shafin244/Team-Boolean-Autocrates_SAP-1-Architecture-based-8-bit-Computer-Design/BOOLEAN AUTOCRATS_SAP 1_FINAL.png

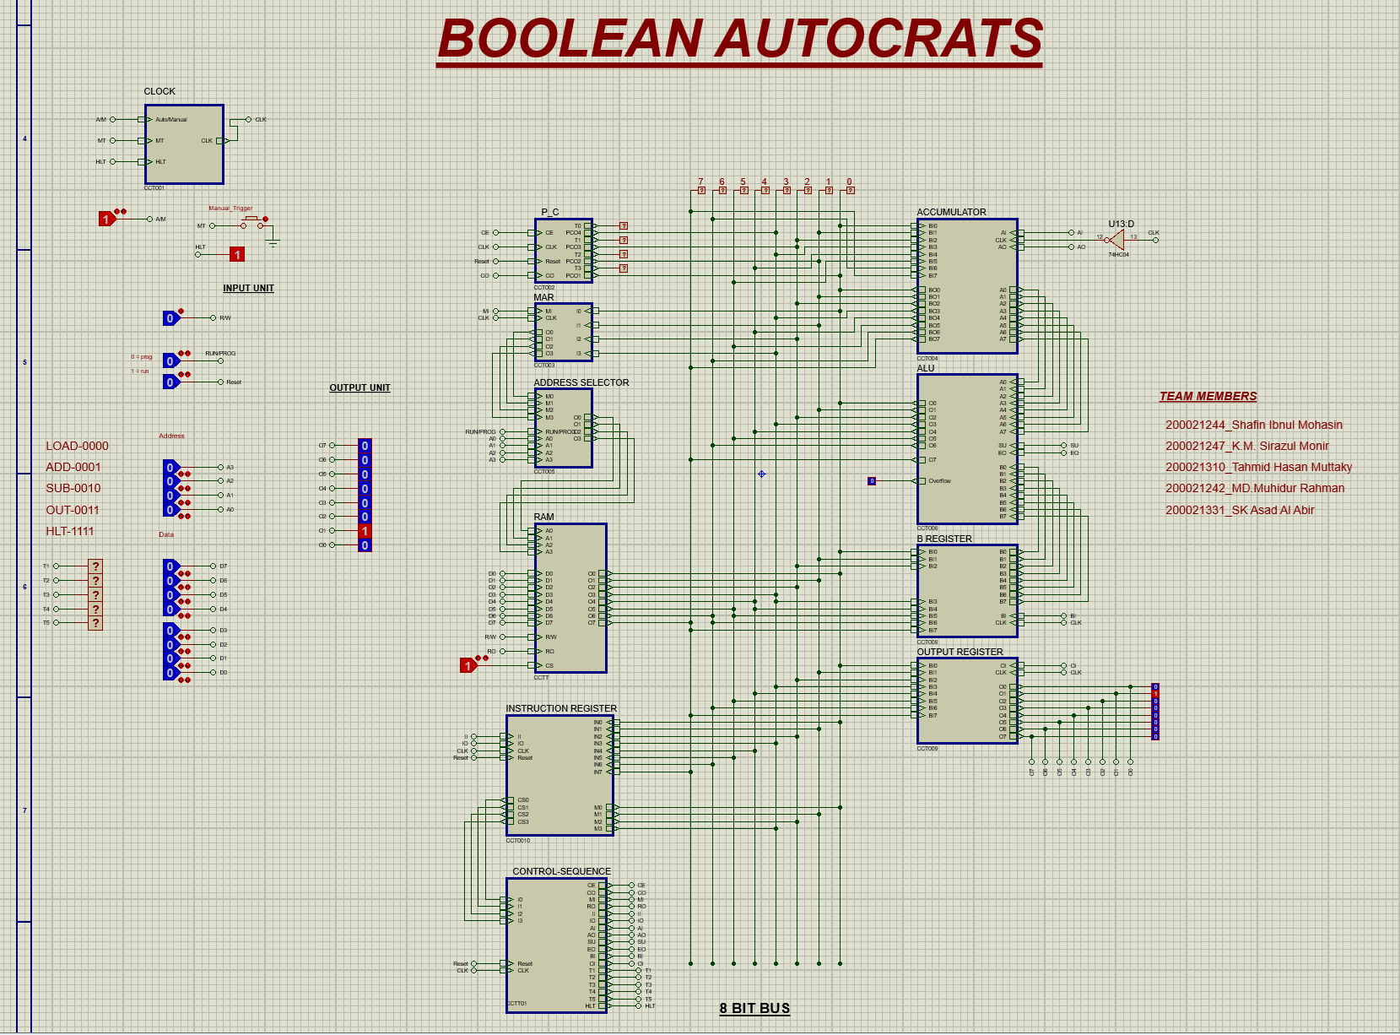
BOOLEAN AUTOCRATS_SAP 1_FINAL.png
