shafin244/Team-Boolean-Autocrates_SAP-1-Architecture-based-8-bit-Computer-Design/PHASE A/Clock Pulse Generator/PCB of Clock.png

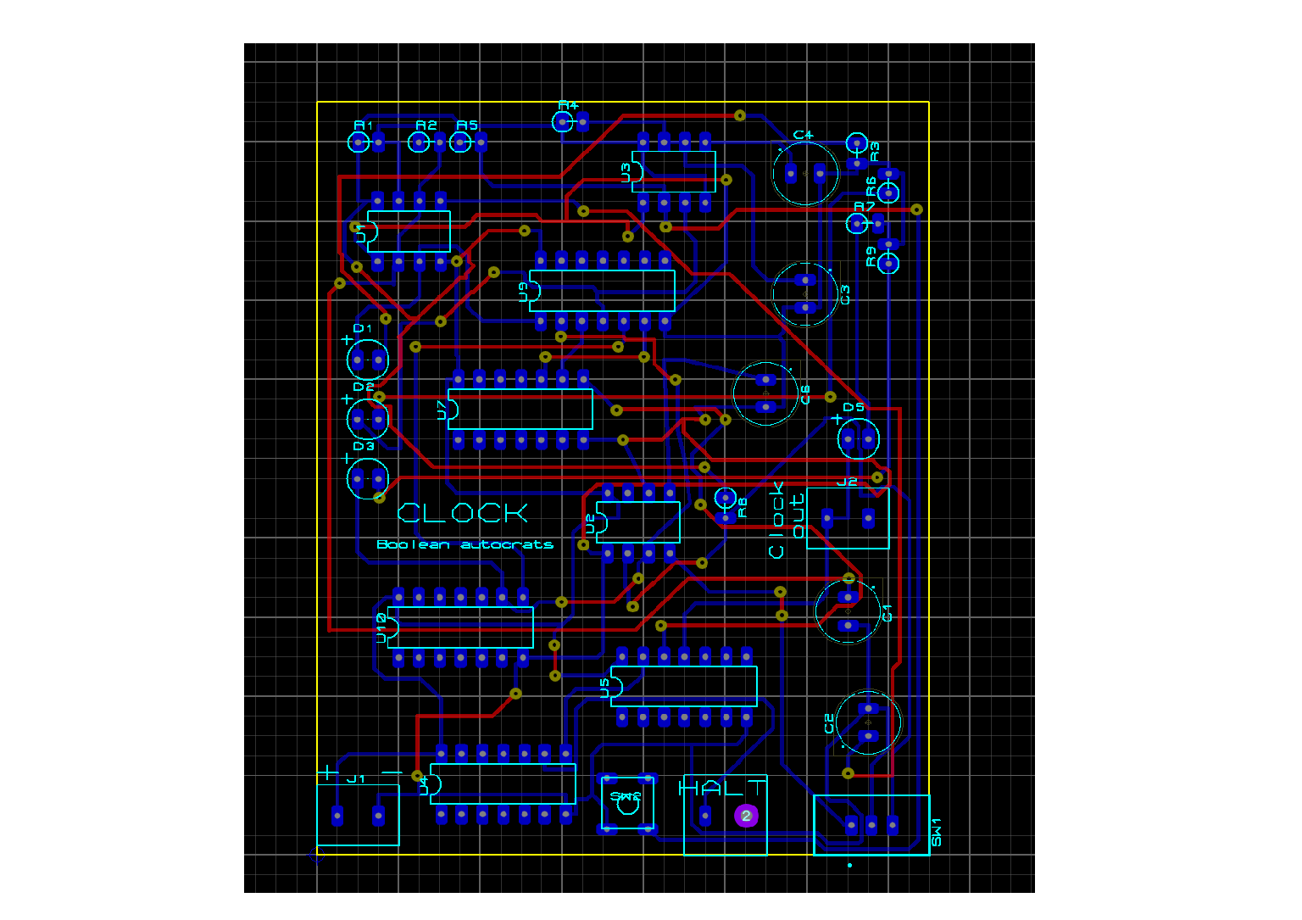
PHASE A/Clock Pulse Generator/PCB of Clock.png
