shafin244/Team-Boolean-Autocrates_SAP-1-Architecture-based-8-bit-Computer-Design/PHASE A/MAR & Program Counter/PCB of MAR & PC.png

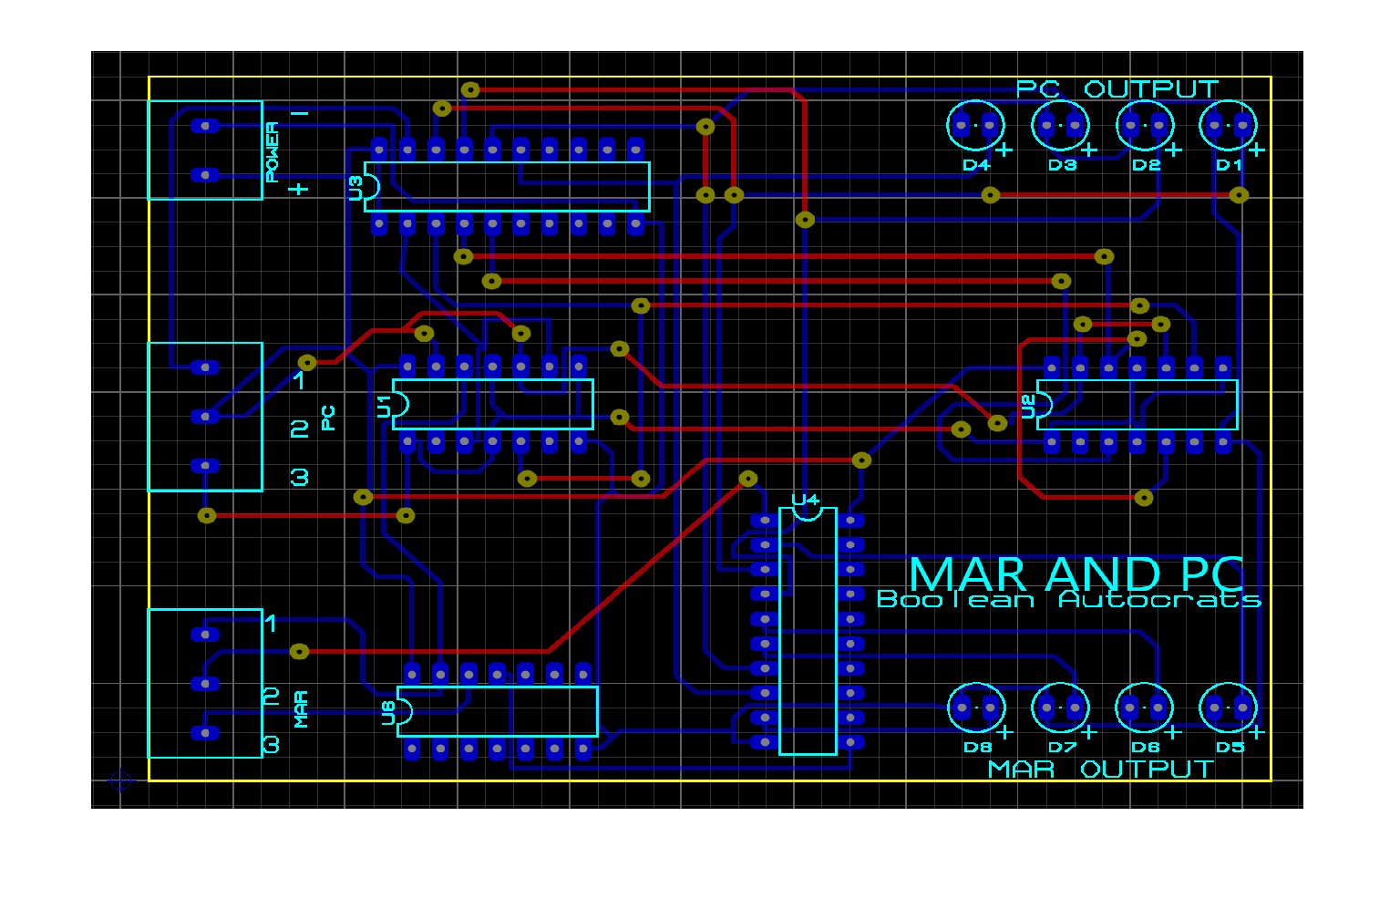
PHASE A/MAR & Program Counter/PCB of MAR & PC.png
