shafin244/Team-Boolean-Autocrates_SAP-1-Architecture-based-8-bit-Computer-Design/PHASE B/ACCUMULATOR/PCB of ACCUMULATOR.png

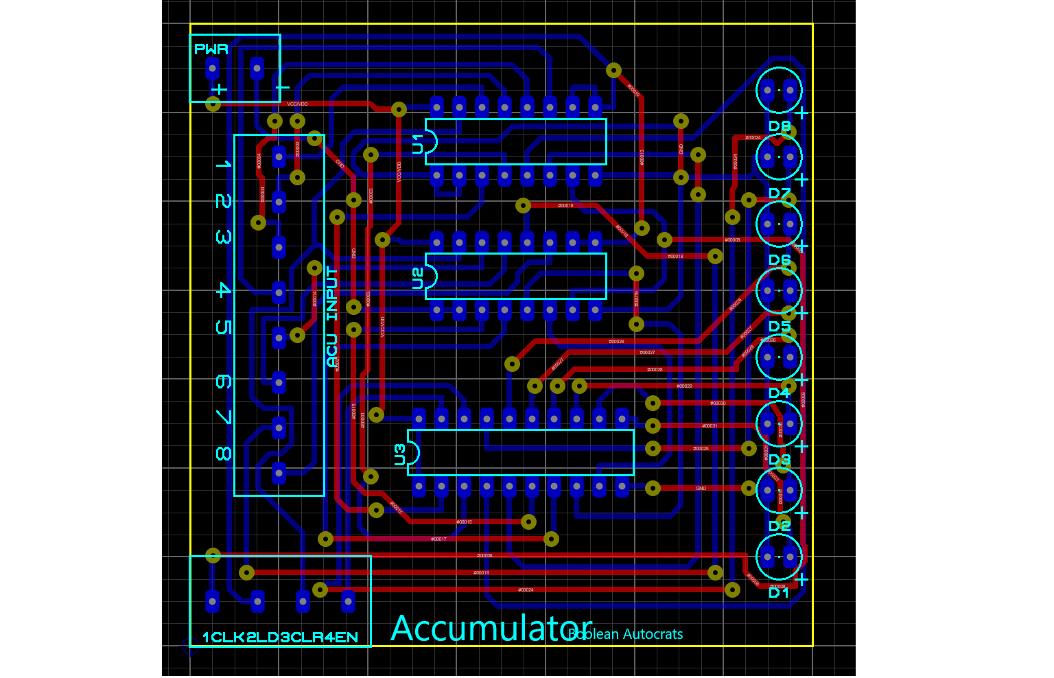
PHASE B/ACCUMULATOR/PCB of ACCUMULATOR.png
