shafin244/Team-Boolean-Autocrates_SAP-1-Architecture-based-8-bit-Computer-Design/PHASE B/B REGISTER/PCB of B REGISTER.png

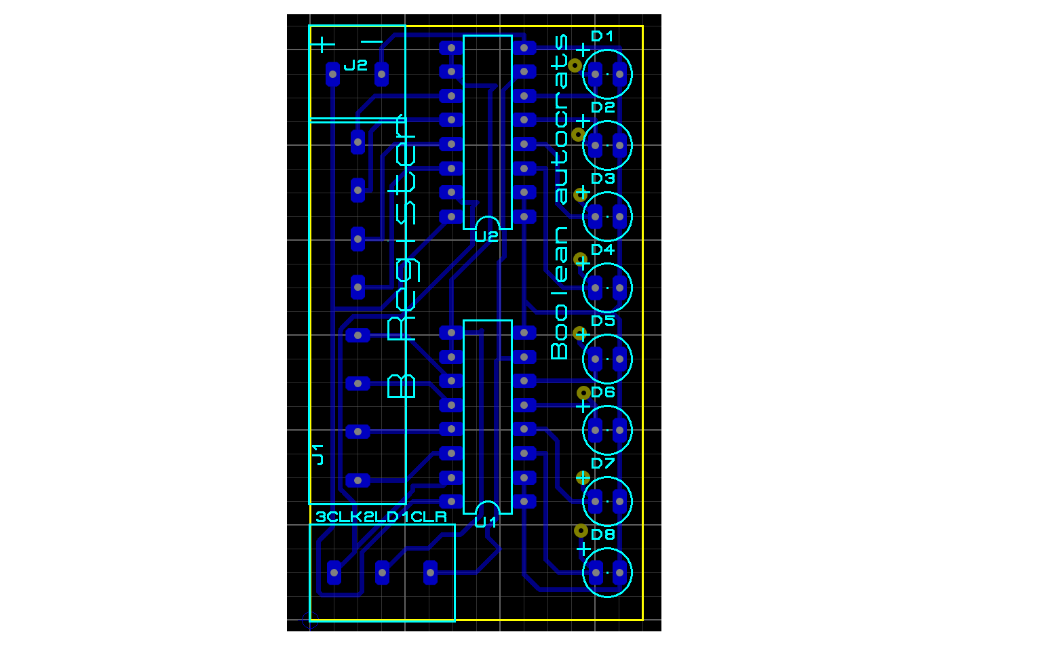
PHASE B/B REGISTER/PCB of B REGISTER.png
