shafin244/Team-Boolean-Autocrates_SAP-1-Architecture-based-8-bit-Computer-Design/PHASE B/RAM module/PCB of RAM.png

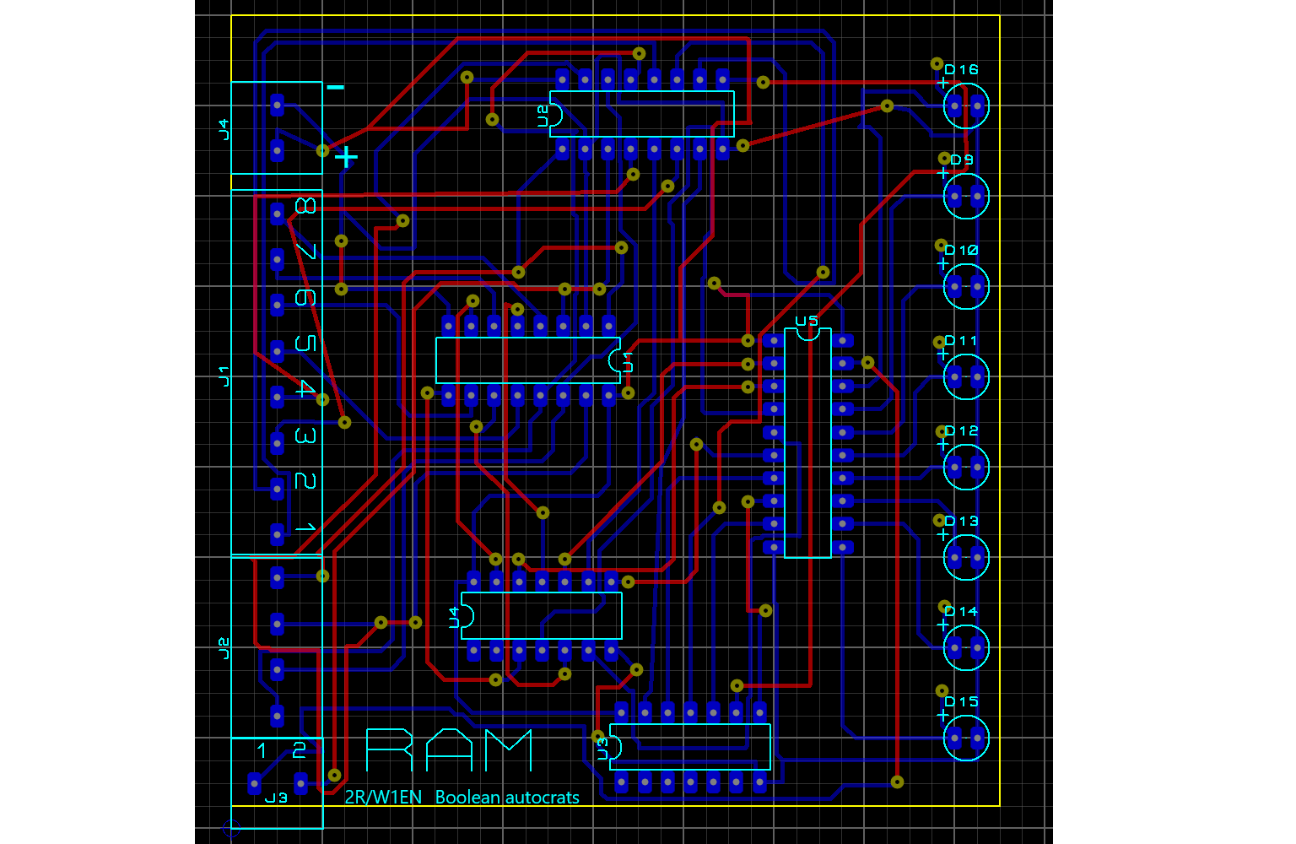
PHASE B/RAM module/PCB of RAM.png
