shafin244/Team-Boolean-Autocrates_SAP-1-Architecture-based-8-bit-Computer-Design/PHASE C/CONTROL UNIT/PCB of Control UNIT.png

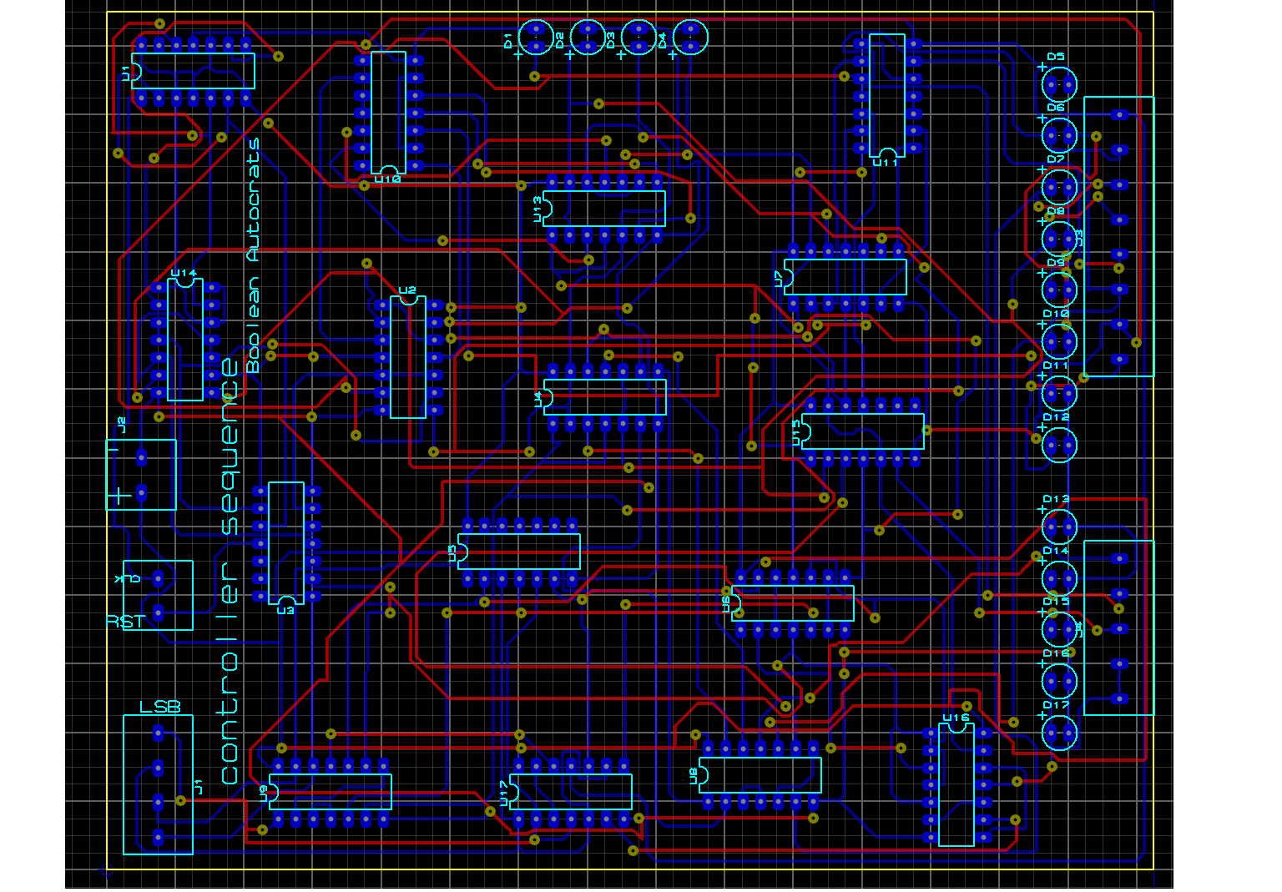
PHASE C/CONTROL UNIT/PCB of Control UNIT.png
