shafin244/Team-Boolean-Autocrates_SAP-1-Architecture-based-8-bit-Computer-Design/PHASE D/PCB of ALU.png

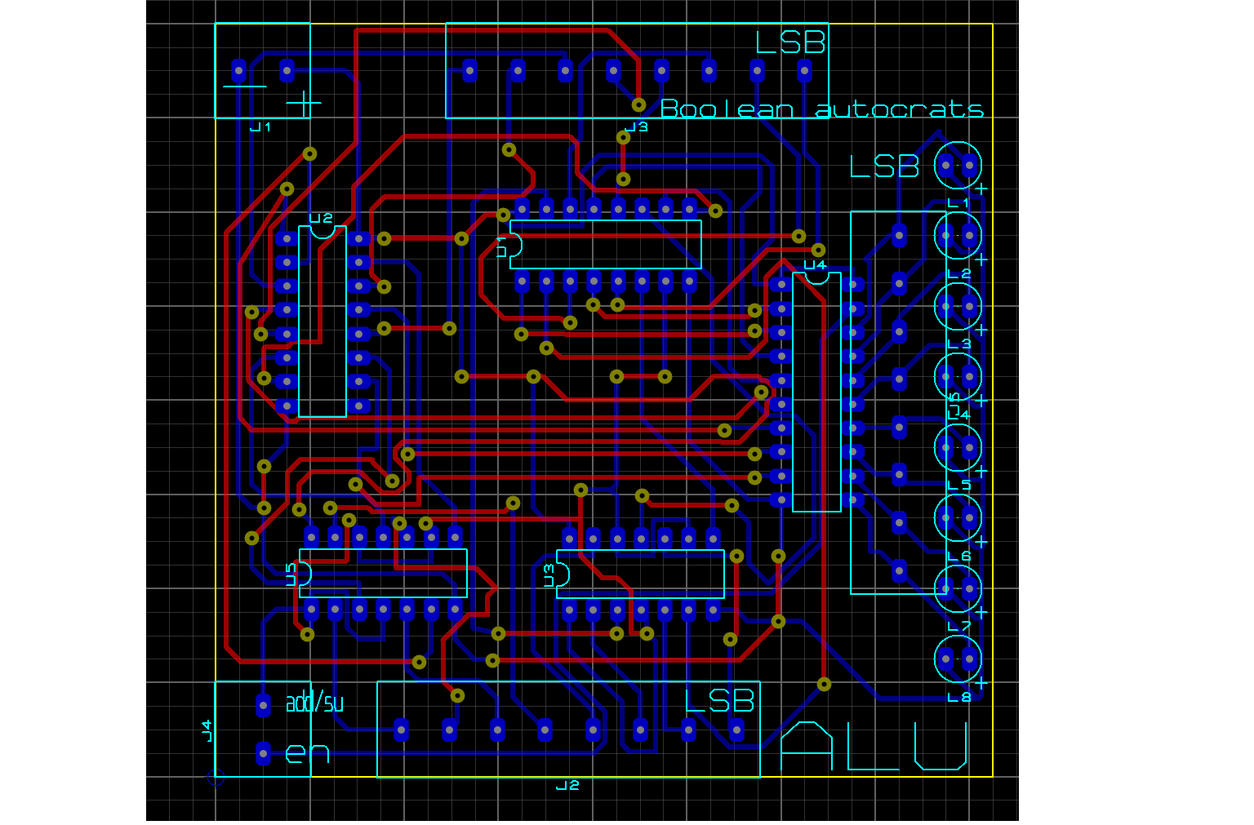
PHASE D/PCB of ALU.png
