shafin244/Team-Boolean-Autocrates_SAP-1-Architecture-based-8-bit-Computer-Design/PHASE C/INSTRUCTION REGISTER/PCB of Instruction Register.png

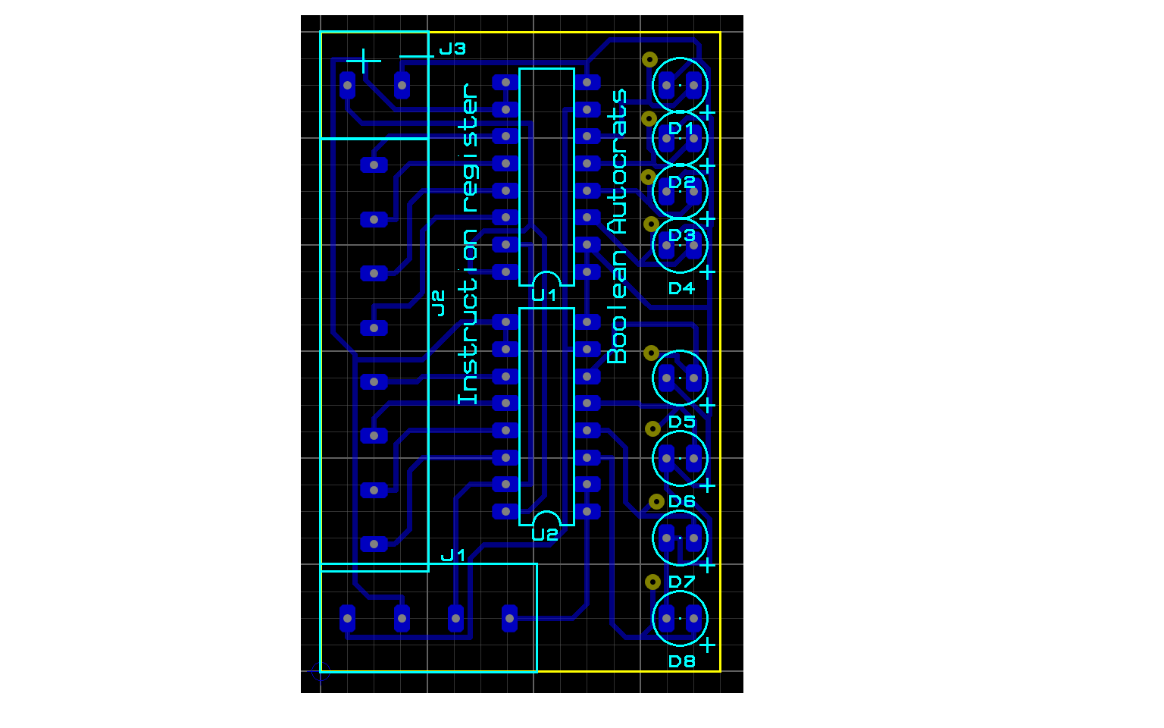
PHASE C/INSTRUCTION REGISTER/PCB of Instruction Register.png
