shafin244/Team-Boolean-Autocrates_SAP-1-Architecture-based-8-bit-Computer-Design/(list of files, drawings)

Other design files:
BOOLEAN AUTOCRATS_SAP 1_FINAL.pdsprj
PHASE A/ALL 3 COMBINED/PHASE A.pdsprj
PHASE A/Clock Pulse Generator/clock pcb.pdsprj
PHASE A/MAR & Program Counter/mar and pc PCB 2.pdsprj
PHASE B/ACCUMULATOR/ACCUmulator PCB.pdsprj
PHASE B/B REGISTER/B register PCb.pdsprj
PHASE B/OUTPUT REGISTER/OUTPUT register PCb.pdsprj
PHASE B/RAM module/RAM module PCB.pdsprj
PHASE C/CONTROL UNIT/Controller sequence pcb.pdsprj
PHASE C/INSTRUCTION REGISTER/Intruction Register pcb.pdsprj
PHASE D/ALU pcb.pdsprj
